jeffsponaugle/Kartana9/images/IMG_7429.jpeg

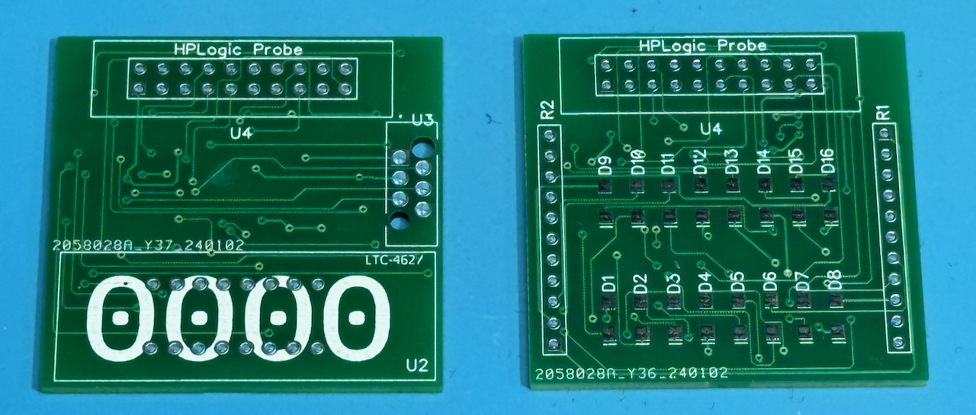
images/IMG_7429.jpeg
