jeffsponaugle/Kartana9/images/IMG_7432.jpeg

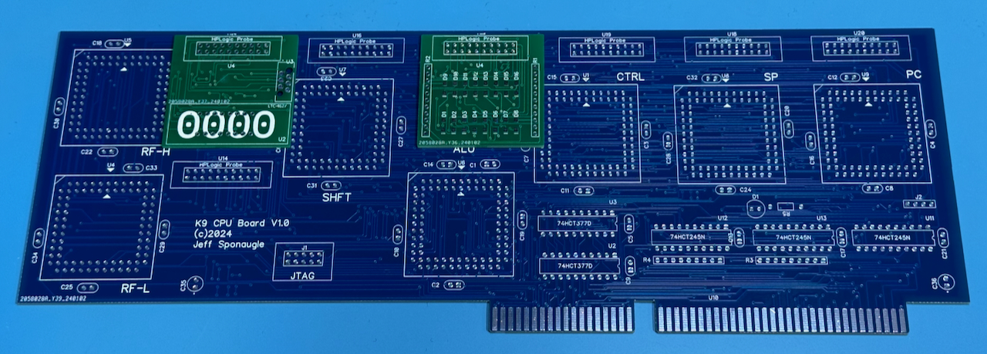
images/IMG_7432.jpeg
