jeffsponaugle/Kartana9/images/IMG_7433.jpeg

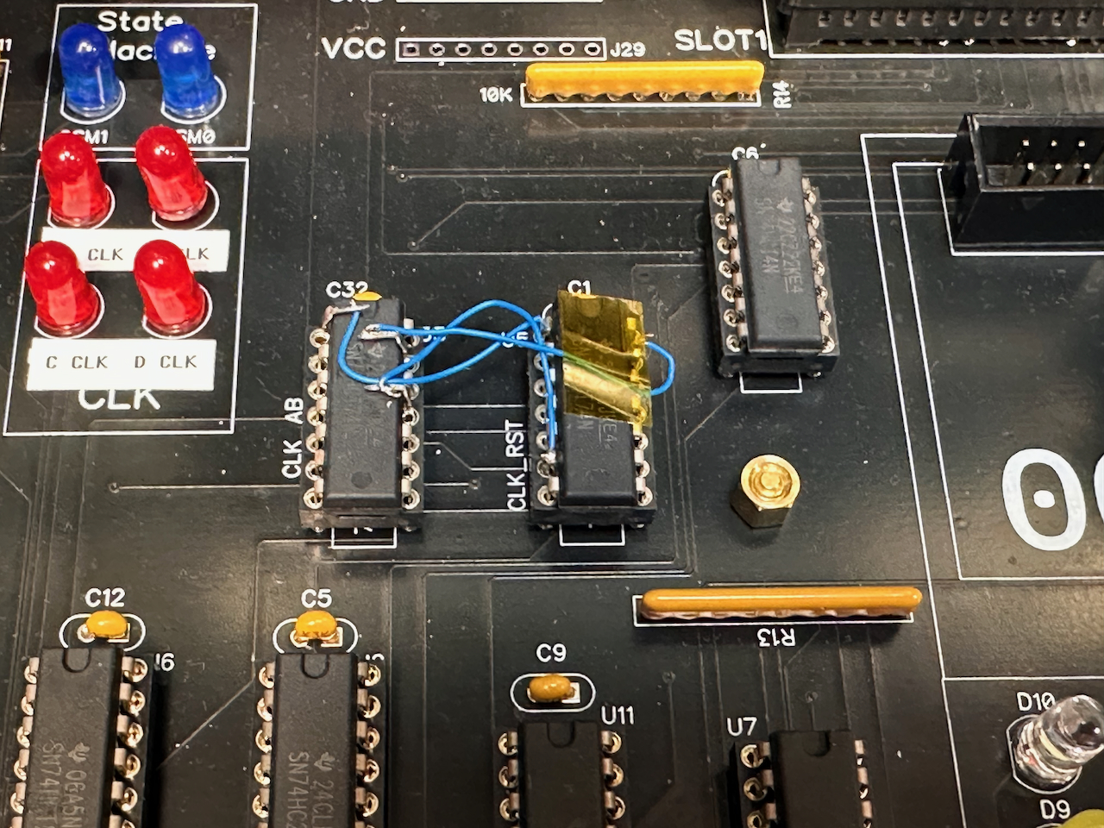
images/IMG_7433.jpeg
