jeffsponaugle/Kartana9/(list of files, drawings)

Other design files:
CPUKit_ASBUILT/schematics/16LEDBoard.dch
CPUKit_ASBUILT/schematics/16LEDBoard_PREROUTE.dip
CPUKit_ASBUILT/schematics/16LEDBoard_ROUTED.dip
CPUKit_ASBUILT/schematics/47SEGDBoardV2.dch
CPUKit_ASBUILT/schematics/47SegDBoardV2_PREROUTE.dip
CPUKit_ASBUILT/schematics/47SegDBoardV2_ROUTED.dip
CPUKit_ASBUILT/schematics/BaseBoard.dch
CPUKit_ASBUILT/schematics/BaseBoardBackup.dch
CPUKit_ASBUILT/schematics/BaseBoardPCB.dip
CPUKit_ASBUILT/schematics/BaseBoardPCB_PREROUTE.dip
CPUKit_ASBUILT/schematics/BaseBoardPCB_ROUTED.dip
CPUKit_ASBUILT/schematics/BaseBoardPCBPostRoute.dip
CPUKit_ASBUILT/schematics/BaseBoardPCBUnRouted.dip
CPUKit_ASBUILT/schematics/CPUBoardB_PREROUTE.dip
CPUKit_ASBUILT/schematics/CPUBoardB_ROUTED.dip
CPUKit_ASBUILT/schematics/K9MainBoard.dch
CPUKit_ASBUILT/schematics/K9RAMBoard.dch
CPUKit_ASBUILT/schematics/K9RAMBoard_PREROUTE.dip
CPUKit_ASBUILT/schematics/K9RAMBoard_ROUTED.dip
CPUKit_InDev/16LEDBoard.dch
CPUKit_InDev/16LEDBoard_PREROUTE.dip
CPUKit_InDev/47SEGDBoardV2.dch
CPUKit_InDev/47SegDBoardV2_PREROUTE.dip
CPUKit_InDev/47SegDBoardV2_ROUTED.dip
CPUKit_InDev/47SEGDBoardV3.dch
CPUKit_InDev/47SegDBoardV3_PREROUTED.dip
CPUKit_InDev/BaseBoard.dch
CPUKit_InDev/BaseBoardBackup.dch
CPUKit_InDev/BaseBoardPCB.dip
CPUKit_InDev/BaseBoardPCB_PREROUTE.dip
CPUKit_InDev/BaseBoardPCB_ROUTED.dip
CPUKit_InDev/BaseBoardPCBPostRoute.dip
CPUKit_InDev/BaseBoardPCBUnRouted.dip
CPUKit_InDev/CPUBoardB_PREROUTE.dip
CPUKit_InDev/K9MainBoard.dch
CPUKit_InDev/K9RAMBoard.dch
CPUKit_InDev/K9RAMBoard_PREROUTE.dip
