jeffsponaugle/Kartana9/(commit log)

2024-01-23 New 7Seg V3 PCB
    [47SEGDBoardV3.dch, 47SegDBoardV3_PREROUTED.dip]
2024-01-23 Updated 7SegV2 code
    Working code for 7 segment display PCB V2
2024-01-29 Assembler test
2024-01-29 Updated Assembler
2024-01-31 Assembler bin output
2024-01-31 Assembler bin output fixed
2024-02-01 Assembler String Data improved
2024-02-01 Assembler hex output cap
2024-02-02 Added RESET to ALU pin 36
2024-02-02 Added OPCODE to lst output in assembler
2024-02-04 new asm test case
    [MicroCPUInstructionWord.xlsx]
2024-02-04 changes to instruction naming
    [MicroCPUInstructionWord.xlsx]
2024-02-13 Prime Number test case
    [MicroCPUInstructionWord.xlsx]
2024-02-13 Prime Number test case 2
2024-03-07 Support for EffAdd A2D Routing in SP
    [MicroCPUInstructionWord.xlsx]
2024-04-07 Updated README '
    [16LEDBoard.dch, 16LEDBoard_PREROUTE.dip, 16LEDBoard_ROUTED.dip, 47SEGDBoardV2.dch, 47SEGDBoardV3.dch, 47SegDBoardV2_PREROUTE.dip, 47SegDBoardV2_ROUTED.dip, 47SegDBoardV3_PREROUTED.dip]
